openUC2/openuc2-xiao-target-camera/docs/xiao_target_roll.png

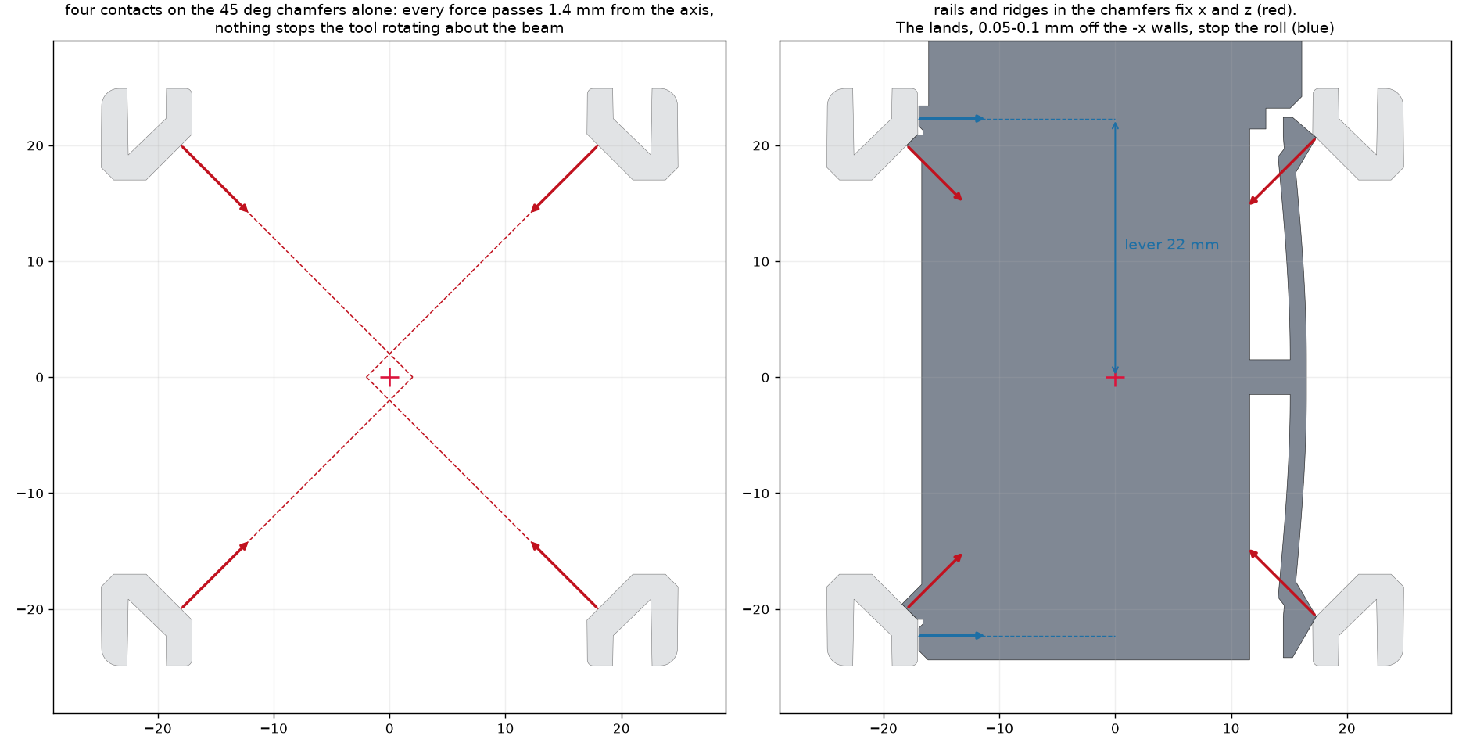
docs/xiao_target_roll.png
