openUC2/openuc2-xiao-target-camera/docs/xiao_target_section_x0.png

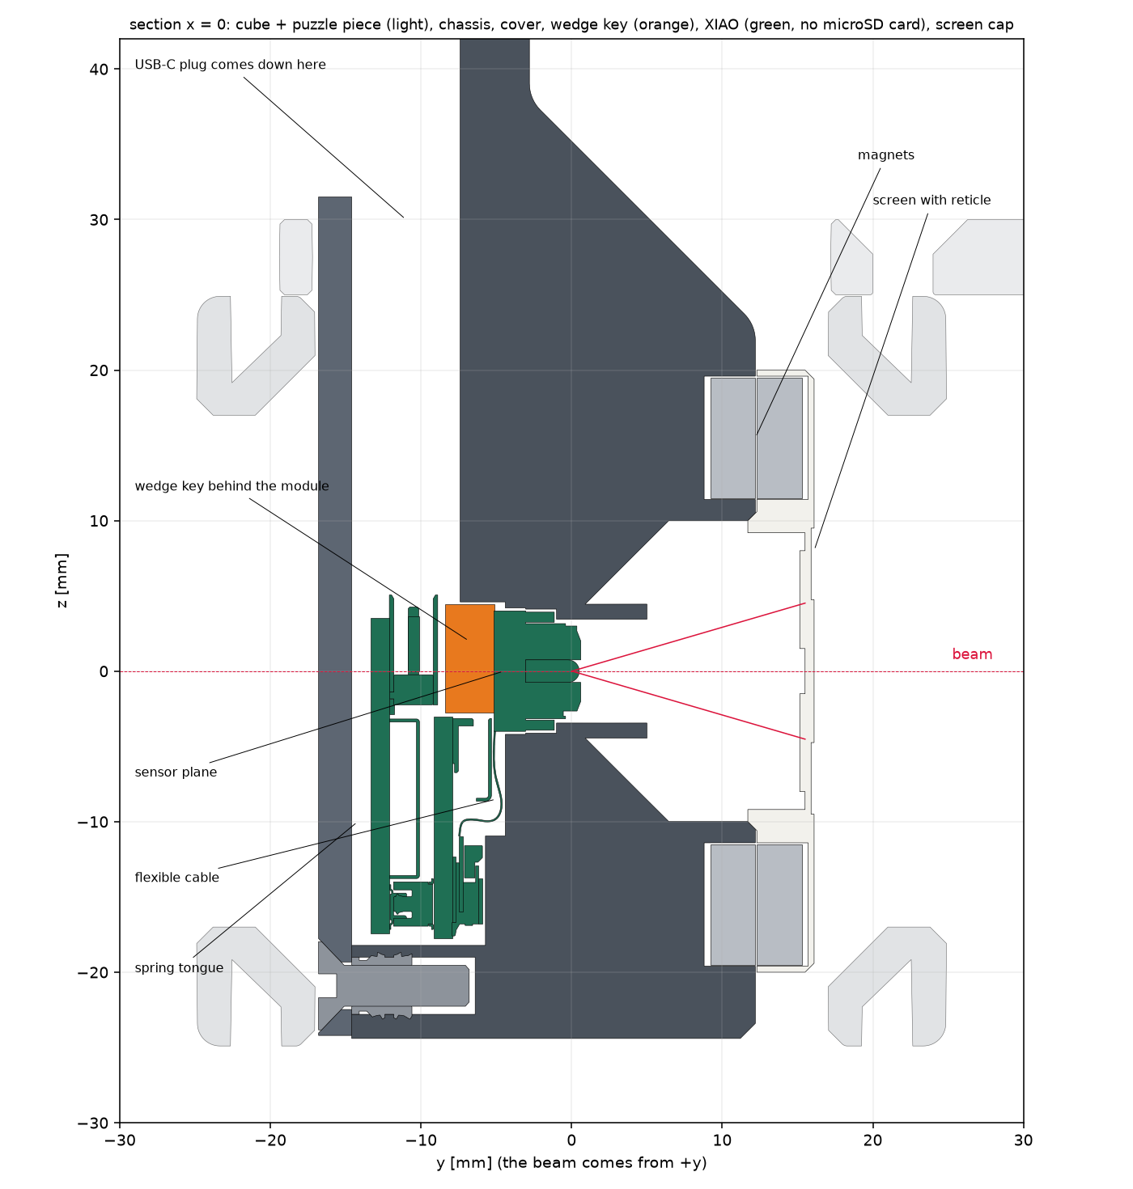
docs/xiao_target_section_x0.png
