openUC2/openuc2-xiao-target-camera/docs/xiao_target_side_entry.png

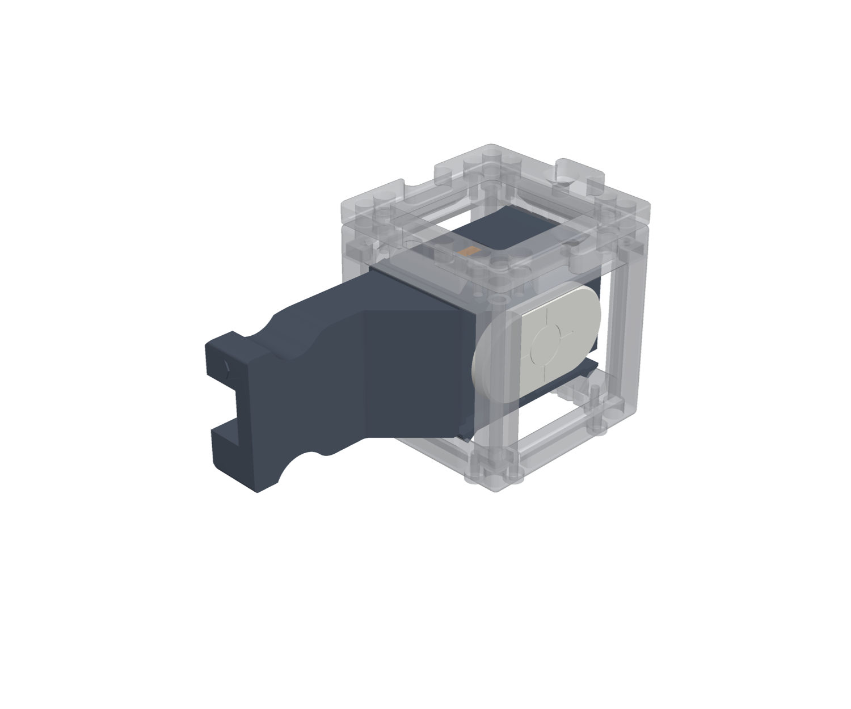
docs/xiao_target_side_entry.png
