openUC2/openuc2-xiao-target-camera/stl/PRT - 9040 - CAMTARXIA - V04.stl

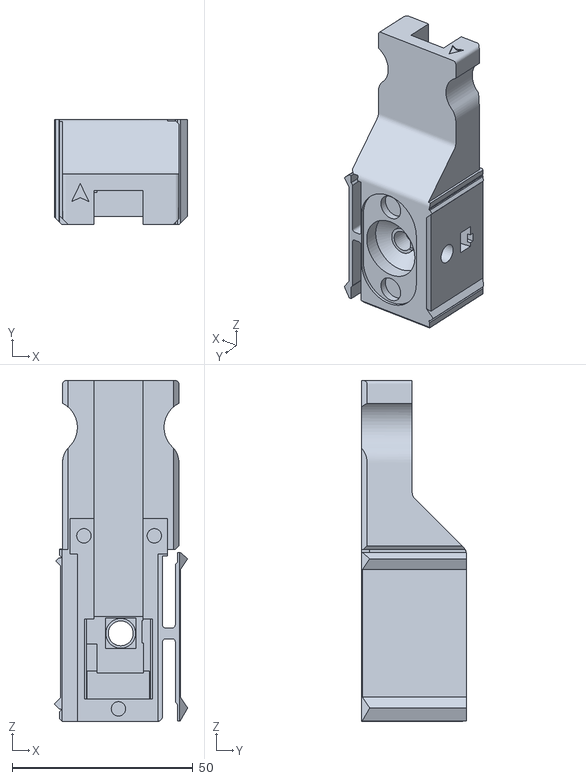
[picture p12: CAD file, 2026-11-06]
stl/PRT - 9040 - CAMTARXIA - V04.stl
36.9 x 29.0 x 94.4
