openUC2/openuc2-xiao-target-camera/stl/PRT - 9041 - CAMTARCOV - V04.stl

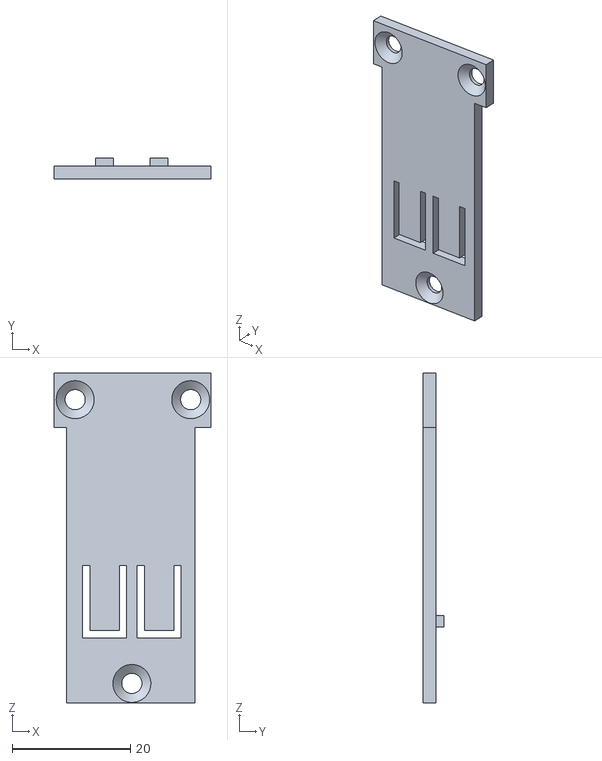
[picture p13: CAD file, 2026-11-06]
stl/PRT - 9041 - CAMTARCOV - V04.stl
26.4 x 3.55 x 55.7
