openUC2/openuc2-xiao-target-camera/INVENTOR/ASS - 9039 - CAMTARXIA - V04 - side entry.stp

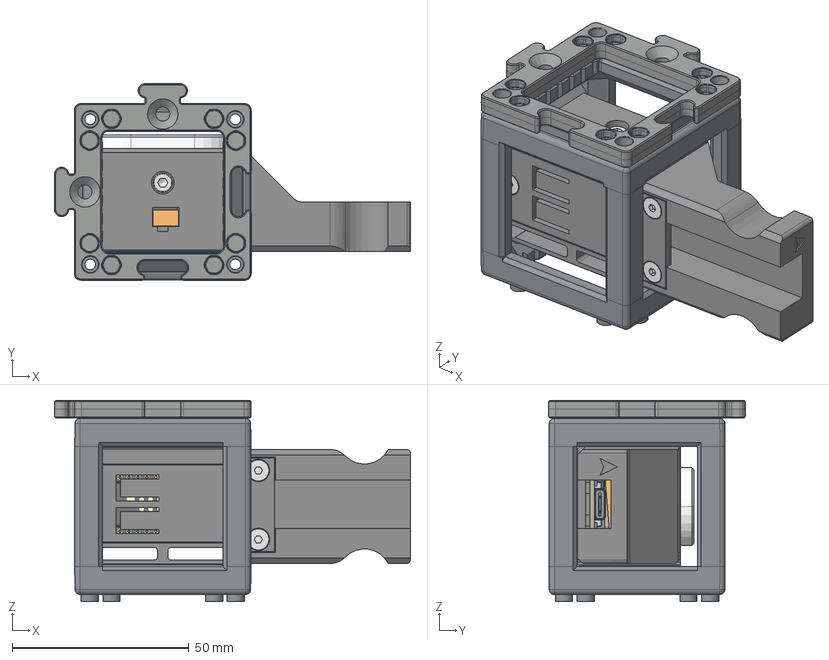
[picture p14: CAD file, 2026-11-06]
INVENTOR/ASS - 9039 - CAMTARXIA - V04 - side entry.stp
100.6 x 55.6 x 56.9 mm
PRT - 1003 - CUBHLF111 - V04 x 2
PRT - 1004 - PUZ11 - V04 - A
PRT - 9040 - CAMTARXIA - V04
PRT - 9041 - CAMTARCOV - V04
PRT - 9033 - CAMTARKEY - V04
PRT - 9034 - CAMTARSCR - V04
BOSS-EXTRUDE14_8_
BOSS-EXTRUDE7_4_
BOSS-EXTRUDE7_3_
BOSS-EXTRUDE14_4_
BOSS-EXTRUDE14_2_
BOSS-EXTRUDE14_11_
BOSS-EXTRUDE7_7_
BOSS-EXTRUDE14_9_
BOSS-EXTRUDE14_3_
BOSS-EXTRUDE14_7_
MIRROR2
BOSS-EXTRUDE14_5_
BOSS-EXTRUDE14_12_
BOSS-EXTRUDE7_8_
BOSS-EXTRUDE7_1_
BOSS-EXTRUDE14_10_
BOSS-EXTRUDE7_9_
BOSS-EXTRUDE14_6_
BOSS-EXTRUDE14_1_
BOSS-EXTRUDE7_6_
BOSS-EXTRUDE7_2_
CUT-EXTRUDE5
BOSS-EXTRUDE7_5_
Shield
Pins x 2
U.FL-R-SMT-1_10_ v1
DF40C-30DP-0.4V_51_ v1
DF40HC(3.0)-30DS
10067099-200LF v1
PCB
MicroSD v2
JUSHUO AFC01-S24FCA-00
Camer Module
BUY - NeFeB-Magnet - ø8x3 N40 Ni x 4
BUY - Ruthex - RX-M3Sx4.0 x 4
ISO 10642 - M3 x 10 - A2-70 x 3
ISO 4762 - M3 x 8 - A2-70
