openUC2/openuc2-xiao-target-camera/stl/PRT - 9033 - CAMTARKEY - V04.stl

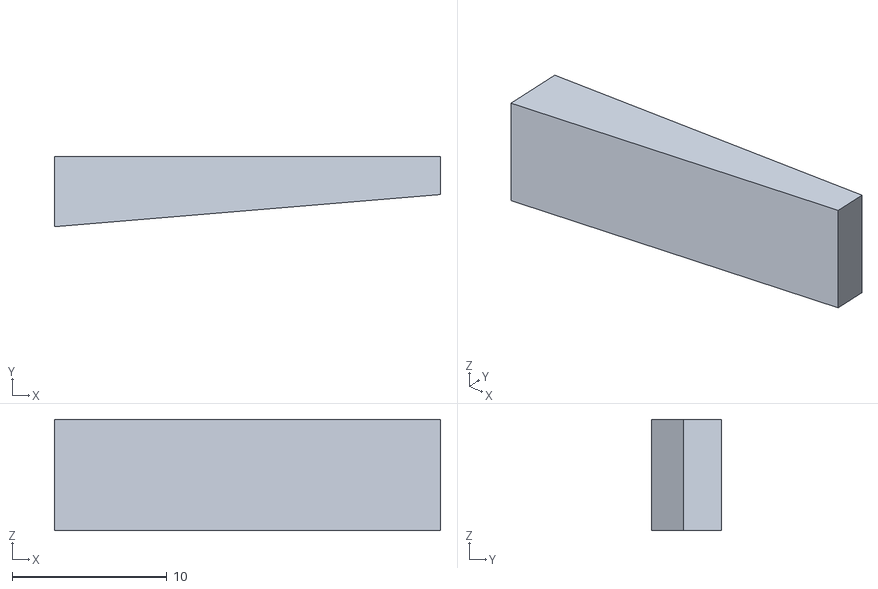
[picture p15: CAD file, 2026-11-06]
stl/PRT - 9033 - CAMTARKEY - V04.stl
24.9 x 4.55 x 7.20
