openUC2/openuc2-xiao-target-camera/INVENTOR/PRT - 9041 - CAMTARCOV - V04.stp

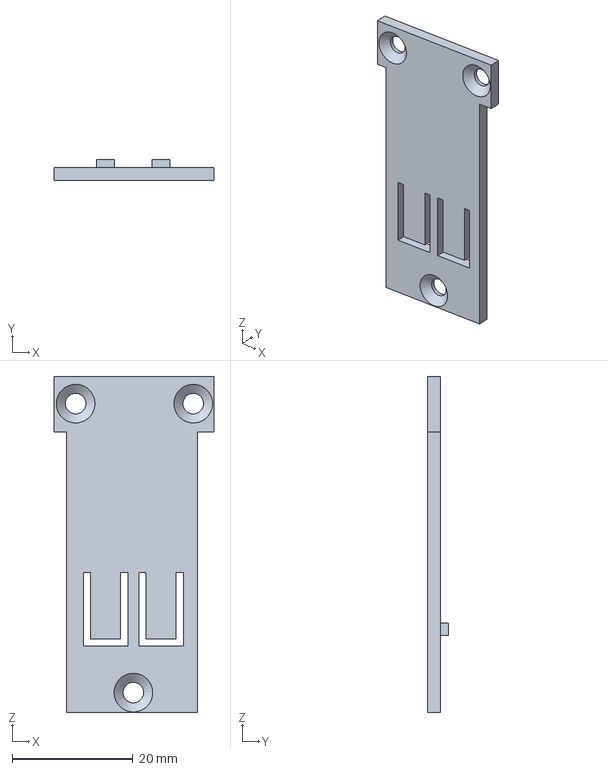
[picture p16: CAD file, 2026-11-06]
INVENTOR/PRT - 9041 - CAMTARCOV - V04.stp
26.4 x 3.55 x 55.7 mm
