openUC2/openuc2-xiao-target-camera/stl/PRT - 9034 - CAMTARSCR - V04.stl

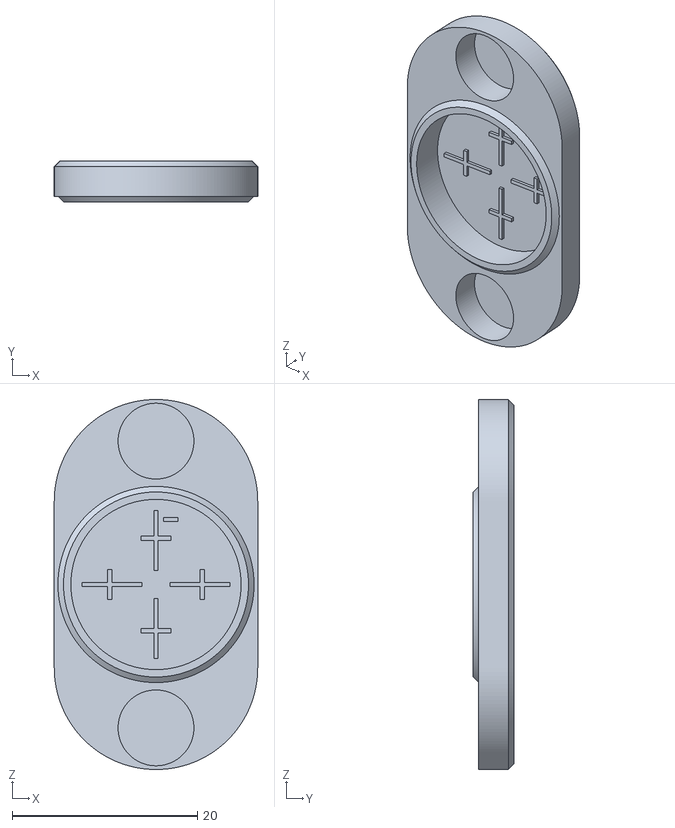
[picture p17: CAD file, 2026-11-06]
stl/PRT - 9034 - CAMTARSCR - V04.stl
22.0 x 4.40 x 40.0
