openUC2/openuc2-xiao-target-camera/stl/PRT - 9035 - CAMTARNDF - V04.stl

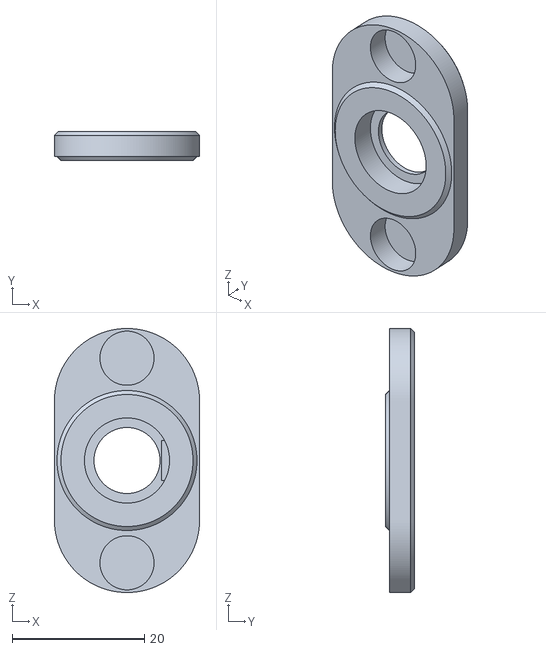
[picture p18: CAD file, 2026-11-06]
stl/PRT - 9035 - CAMTARNDF - V04.stl
22.0 x 4.40 x 40.0
