openUC2/openuc2-xiao-target-camera/(list of files, cad)

Other CAD files:
INVENTOR/PRT - 9040 - CAMTARXIA - V04.stp
INVENTOR/PRT - 9033 - CAMTARKEY - V04.stp
INVENTOR/PRT - 9034 - CAMTARSCR - V04.stp
INVENTOR/PRT - 9035 - CAMTARNDF - V04.stp
INVENTOR/ASS - 9039 - CAMTARXIA - V04 - side entry.iam
INVENTOR/ASS - 9039 - CAMTARXIA - V04.iam
INVENTOR/PRT - 9033 - CAMTARKEY - V04.ipt
INVENTOR/PRT - 9034 - CAMTARSCR - V04.ipt
INVENTOR/PRT - 9035 - CAMTARNDF - V04.ipt
INVENTOR/PRT - 9040 - CAMTARXIA - V04.ipt
INVENTOR/PRT - 9040 - CAMTARXIA - V04.stl
INVENTOR/PRT - 9041 - CAMTARCOV - V04.ipt
