openUC2/openuc2-xiao-target-camera/(commit log)

2026-11-06 cleaning up, adding margins, simplify printing
    [ASS - 9020 - CAMTARXIA - V04 - standalone.0001.iam, ASS - 9020 - CAMTARXIA - V04 - standalone.0002.iam, ASS - 9020 - CAMTARXIA - V04 - standalone.iam, ASS - 9020 - CAMTARXIA - V04 - standalone.stp, ASS - 9020 - CAMTARXIA - V04.0001.iam, ASS - 9020 - CAMTARXIA - V04.0002.iam, ASS - 9020 - CAMTARXIA - V04.iam, ASS - 9020 - CAMTARXIA - V04.stp]
2026-11-06 updating files
    [PRT - 9040 - CAMTARXIA - V04.ipt, PRT - 9040 - CAMTARXIA - V04.stl]
2026-11-06 minor change in strength of spring
    [PRT - 9040 - CAMTARXIA - V04.ipt, PRT - 9040 - CAMTARXIA - V04.stl]
